YangXi2016/ROBOT/电路部分/巡线模块电路/巡线模块电路.jpg

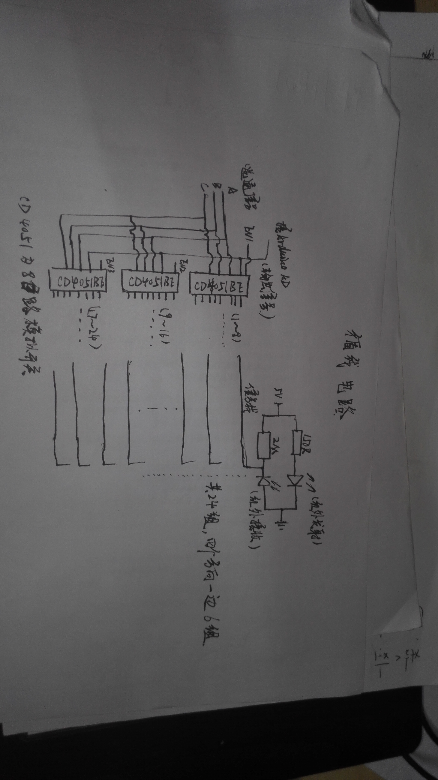
电路部分/巡线模块电路/巡线模块电路.jpg
