YangXi2016/ROBOT/机械部分/整机图/整机.jpg

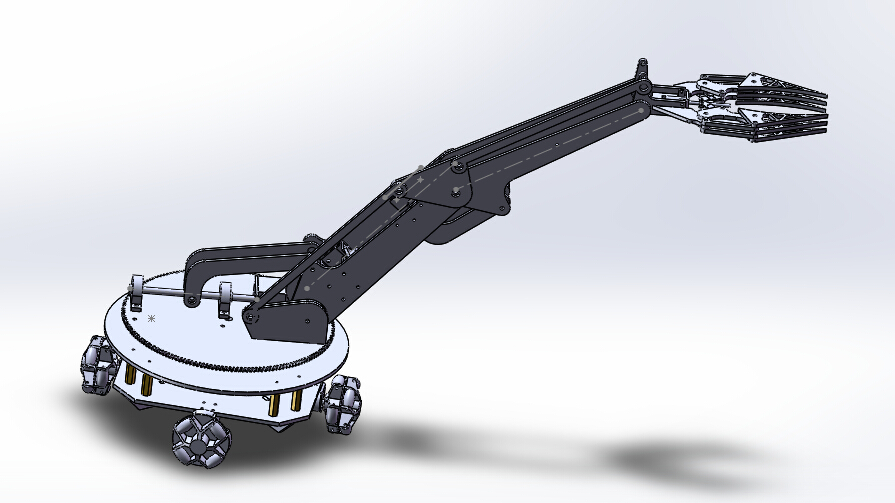
机械部分/整机图/整机.jpg
