YangXi2016/ROBOT/软件部分/上位机程序/ReadME.txt

			暂定组的上位机代码
	文件夹中包含中控杯暂定组的上位机代码，其中文件根目录为运行时的代码，detector
目录下为识别代码。
	由于版权原因，在这里不提供软件源代码，只提供相关的头文件、连接文件和可执行程
序。
