YangXi2016/ROBOT/机械部分/底座/底座.jpg

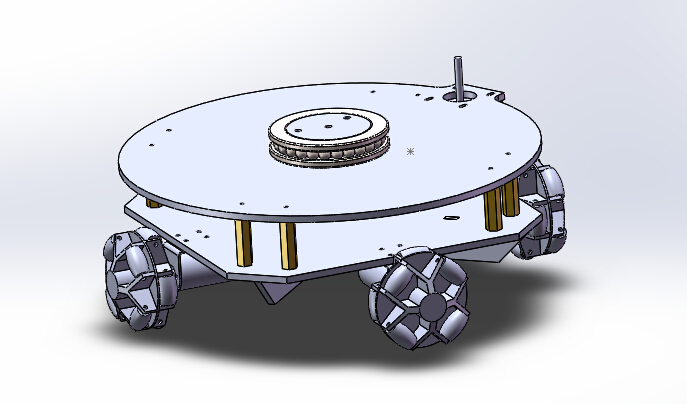
机械部分/底座/底座.jpg
