YangXi2016/ROBOT/机械部分/底座/底座加强肋.jpg

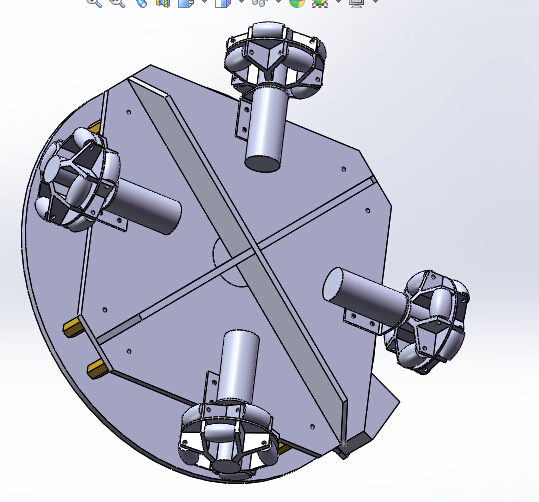
机械部分/底座/底座加强肋.jpg
