YangXi2016/ROBOT/机械部分/机械爪/机械爪.jpg

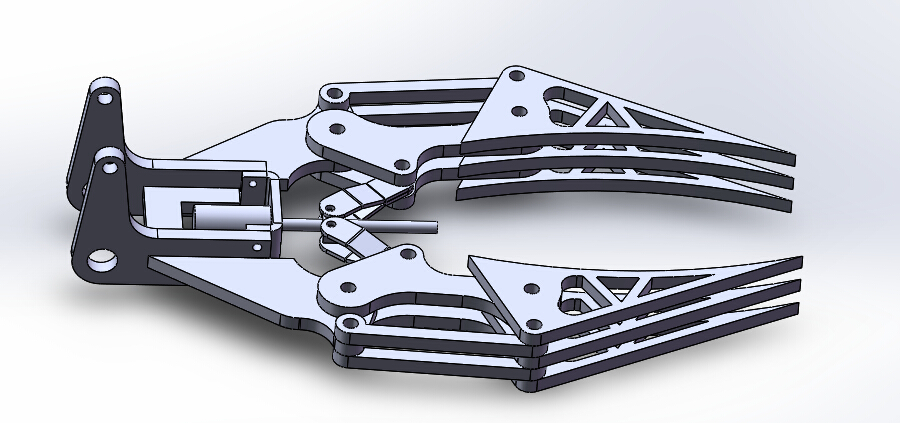
机械部分/机械爪/机械爪.jpg
