YangXi2016/ROBOT/机械部分/机械爪/机械爪详解.png

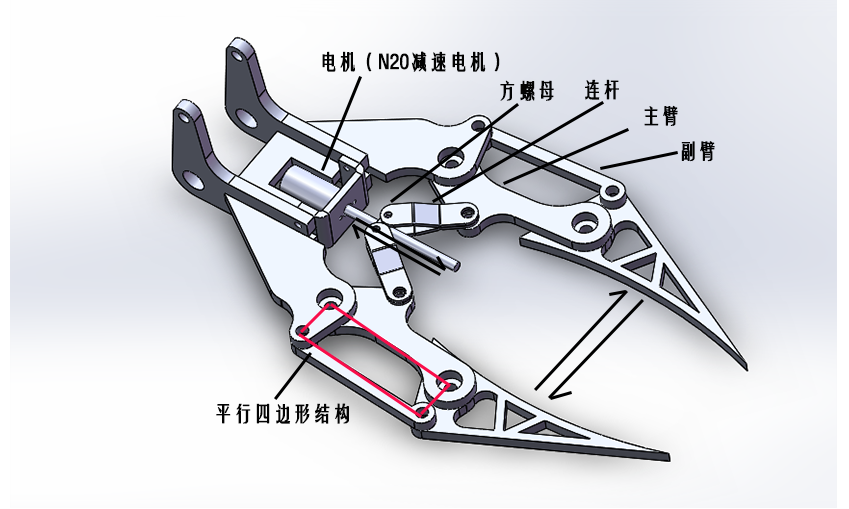
机械部分/机械爪/机械爪详解.png
