YangXi2016/ROBOT/机械部分/机械臂/机械臂.jpg

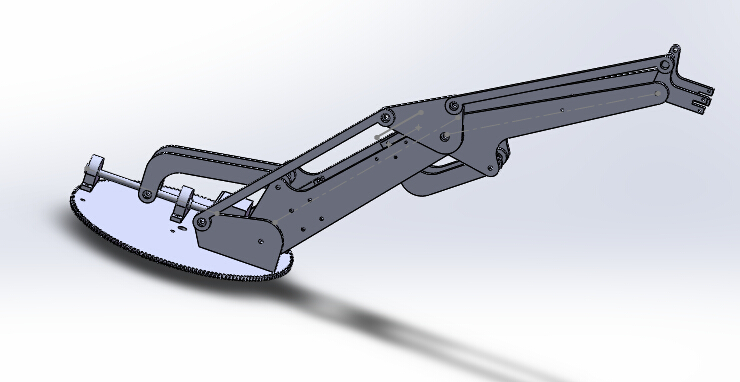
机械部分/机械臂/机械臂.jpg
