YangXi2016/ROBOT/机械部分/机械臂/机械臂详解1.png

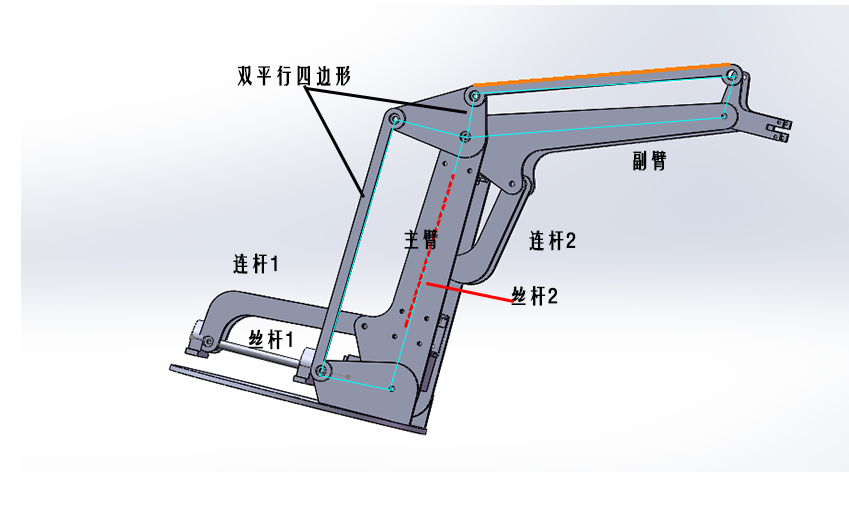
机械部分/机械臂/机械臂详解1.png
