YangXi2016/ROBOT/电路部分/机械臂部分电路/机械臂部分电路.jpg

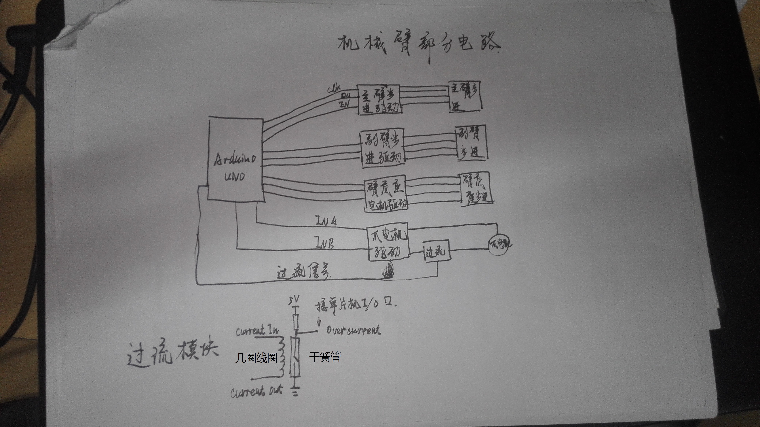
电路部分/机械臂部分电路/机械臂部分电路.jpg
