YangXi2016/ROBOT/软件部分/机械臂驱动模块/ArmControl.cpp

#include<stdio.h>
#include<stdlib.h>
#include<math.h>
#include "ArmControl.h"
#include "DEBUG.h"
//#include "stdafx.h"






int ArmPC::Arm_Move(float Target_X, float Target_Y, float Target_C)
{ 
	//Serial.println(millis());

	float A, B, C, D;
	float AngleTemp;
	float TargetX;     //鍑芥暟鍐呬娇鐢ㄧ殑鐗╀綋鐩爣鍧愭爣 
	float TargetY;
	float TargetC;
	float TargetLength;
	int OverFlag;
	
	if (InitFlag == 0)
	{
		return -1;
	}
	TargetX = Target_X;
	TargetY = Target_Y;
	TargetC = Target_C;
	while (1)
	{
		if (TargetC < ArmP.AngleBaseMin)
			TargetC += PI * 2;
		else if (TargetC > ArmP.AngleBaseMax)
			TargetC -= PI * 2;
		else
			break;
		Serial.println(TargetC);
	}
	

	OverFlag = Base_Assist(&TargetX, &TargetY, &TargetC);
	

	//閫氳繃瑙ｆ柟绋婰engthArm*(cos(a1)+cos(a2))=TargetX; 
	//          LengthArm*(sin(a1)+sin(a2))=TargetY;
	//          a1:AngleArmMain
	//          a2:AngleArmDeputy
	  A = TargetX * TargetX + TargetY * TargetY - 2 * ArmP.LengthArm * ArmP.LengthArm;
	  B = 2 * ArmP.LengthArm * ArmP.LengthArm;
	  if (fabs(A / B) > 1)
		  ArmS.ArmAngleMD = 0;
	  else
	      ArmS.ArmAngleMD = acos(A/ B);     //寰楀埌涓昏噦鍓噦涔嬮棿澶硅

	  A = TargetX * (cos(ArmS.ArmAngleMD) + 1);
	  B = TargetY * sin(ArmS.ArmAngleMD);
	  C = ArmP.LengthArm * (2 + 2 * cos(ArmS.ArmAngleMD));
	ArmS.ArmAngleMain = acos((A-B)/C) ;//寰楀埌涓昏噦涓庢按骞抽潰澶硅

	ArmS.ArmAngleDeputy = ArmS.ArmAngleMain - ArmS.ArmAngleMD;  //寰楀埌鍓噦涓庢按骞抽潰澶硅                                                                    

	  AngleTemp = PI - ArmS.ArmAngleMain - ArmP.AngleMainHand;
	  A = ArmP.LengthMainHand * cos(AngleTemp);
	  B = ArmP.LengthMainConnect * ArmP.LengthMainConnect - ArmP.LengthMainHand * ArmP.LengthMainHand * sin(AngleTemp) * sin(AngleTemp);
	  TargetLength = A + sqrt(B);
	ArmM.LengthMoveMain = TargetLength - LengthMain;
	LengthMain = TargetLength;

	  AngleTemp = PI - ArmS.ArmAngleMD - ArmP.AngleDeputyHand;
	  A = ArmP.LengthDeputyHand * cos(AngleTemp);
	  B = ArmP.LengthDeputyConnect * ArmP.LengthDeputyConnect - ArmP.LengthDeputyHand * ArmP.LengthDeputyHand * sin(AngleTemp) * sin(AngleTemp);
	  TargetLength = A + sqrt(B);
	ArmM.LengthMoveDeputy = TargetLength - LengthDeputy;
	LengthDeputy = TargetLength;
	
	ArmM.TurnC = TargetC - ArmS.ArmC;
	ArmS.ArmTipX = TargetX;
	ArmS.ArmTipY = TargetY;
	ArmS.ArmC    = TargetC;

	//Serial.println(millis());
	//Serial.println("CacultionOver");
	//Serial.println(ArmM.LengthMoveMain);
	//Serial.println(ArmM.LengthMoveDeputy);
	//Serial.println(ArmM.TurnC);
	OverFlag+=ArmU.Arm_Motion(ArmM.LengthMoveMain, ArmM.LengthMoveDeputy, ArmM.TurnC);
	return OverFlag;


}

void ArmPC::Move_Forward(float Target_X, float Target_Y, float Target_C)
{
	int flag;
	float TargetX;     //鍑芥暟鍐呬娇鐢ㄧ殑鐗╀綋鐩爣鍧愭爣 
	float TargetY;
	float TargetC;
	float Distance;//鐖皷閲岀洰鏍囩殑璺濈
	TargetX = Target_X;
	TargetY = Target_Y;
	TargetC = Target_C;


  //Serial.println("fuck");
	DEB("TargetX ");
	DEB(TargetX);
	DEB("TargetY ");
	DEB(TargetY);
	DEB("TargetC ");
	DEB(TargetC);
	DEB("TipX");
	DEB(ArmS.ArmTipX);
	DEB("TipY");
	DEB(ArmS.ArmTipY);
	DEB("ArmM.LengthMoveMain");
	DEB(ArmM.LengthMoveMain);
	DEB("ArmM.LengthMoveDeputy");
	DEB(ArmM.LengthMoveDeputy);
   do
	{
		Distance = TargetX - ArmS.ArmTipX;
		DEB("Distance ");
		DEB(Distance);
		DEB("TipX");
		DEB(ArmS.ArmTipX);
		DEB("TipY");
		DEB(ArmS.ArmTipY);
		DEB("ArmM.LengthMoveMain");
		DEB(ArmM.LengthMoveMain);
		DEB("ArmM.LengthMoveDeputy");
		DEB(ArmM.LengthMoveDeputy);
		DEB("\n");
		if (Distance >= 10)
		{   

			flag = Arm_Move(ArmS.ArmTipX + 10, TargetY, TargetC);
		}
		else if(Distance <= -5)
			flag = Arm_Move(ArmS.ArmTipX - 10, TargetY, TargetC);

		else
		{
			flag = Arm_Move(TargetX, TargetY, TargetC);
			break;
		}
   } while (ArmM.LengthMoveMain != 0 || ArmM.LengthMoveDeputy != 0 || ArmM.TurnC != 0);
	}



void ArmPC::Init_Arm(int firsttime)
{


    LengthMain = 201.4;
	LengthDeputy = 151;
	ArmM.LengthMoveDeputy = 130;
	ArmM.LengthMoveMain = 85;
	ArmM.TurnC = -2 * PI;
	ArmS.ArmC = ArmP.AngleBaseMin;//鍧愭爣绯荤殑鍘熷洜
	ArmS.ArmTipX = 206.88;
	ArmS.ArmTipY = 267.15;
	BPM.BasePlateMoveA = 0;
	BPM.BasePlateMoveB = 0;
	
	if (firsttime == 1)
	{ 
		ArmU.DafaultSpeedMain = DAFAULT_ARM_SPEED / 2;
		ArmM.LengthMoveDeputy = 30;
		ArmM.LengthMoveMain = 30;
		ArmM.TurnC = 0;
		ArmU.Init(ArmM.LengthMoveMain, ArmM.LengthMoveDeputy, ArmM.TurnC);
		
		ArmU.DafaultSpeedMain = DAFAULT_ARM_SPEED ;
		ArmM.LengthMoveDeputy = 100;
		ArmM.LengthMoveMain = 55;
		ArmM.TurnC = -2*PI;
		ArmU.Init(ArmM.LengthMoveMain, ArmM.LengthMoveDeputy, ArmM.TurnC);
	}
	else
	{
		ArmU.DafaultSpeedMain = DAFAULT_ARM_SPEED;
		ArmU.Init(ArmM.LengthMoveMain, ArmM.LengthMoveDeputy, ArmM.TurnC);
	}
	ArmU.DafaultSpeedMain = DAFAULT_ARM_SPEED;
	InitFlag = 1;

}

void ArmPC::Arm_Wait()
{
	//Serial.println("backing");
	int i;
	//Serial.println("movingtoinit");
	i = Arm_Move(206.88, 267.15,ArmS.ArmC);//鍥炲幓

	i= ArmU.Arm_Motion(15, 15, 0);

	ArmS.ArmTipX = 206.88;
	ArmS.ArmTipY = 267.15;
	LengthMain = 201.4;
	LengthDeputy = 151;

}

ArmPC::ArmPC()
{

	ArmP.LengthMainHand = 66;
	ArmP.AngleMainHand = 0.7155850;
	ArmP.LengthMainConnect = 156;
	ArmP.LengthDeputyHand = 62.5;
	ArmP.AngleDeputyHand = 0.8726646;
	ArmP.LengthDeputyConnect = 106.07;
	ArmP.LengthArm = 250;              //涓昏噦鍜屽壇鑷傜殑闀垮害
	ArmP.AngleMainMin = 0.5149;
	ArmP.AngleMainMax = 100.5/180*PI;          //鍚岀悊 
	ArmP.AngleMDMin = 0;
	ArmP.AngleMDMax = 94.5/180*PI;            //鍚岀悊 
	ArmP.AngleBaseMax = PI*1.45;
	ArmP.AngleBaseMin = -PI / 2;

	InitFlag = 0;
}

int ArmPC::Base_Assist(float *Target_X, float *Target_Y, float *Target_C)
{
	float TargetX, TargetY, TargetC;
	
	TargetX = *Target_X;
	TargetY = *Target_Y;
	TargetC = *Target_C;
	
	int OverLimitFlag=0;
	int i;//寰幆鍙橀噺 
	float BaseMovetoC = 0;
	float MotionTemp;    //璁＄畻涓殑涓棿鍙橀噺 
	struct Boundary
					 //鑷鐢诲嚭鍓噦灏栧彲浠ュ埌杈剧殑鑼冨洿
	{
		float CenterX; //杈圭晫鍦嗗績
		float CenterY;
		float Radius;  //杈圭晫鍗婂緞骞虫柟
		float Ymax;    //杈圭晫Y鑼冨洿
		float Ymin;
		float Distance;
	}B[4];

	B[0].CenterX = ArmP.LengthArm*cos(ArmP.AngleMainMax);
	B[0].CenterY = ArmP.LengthArm*sin(ArmP.AngleMainMax);
	B[0].Radius = ArmP.LengthArm*ArmP.LengthArm;
	if (ArmP.AngleMainMax - ArmP.AngleMDMin >= PI / 2)
		B[0].Ymax = B[0].CenterY + ArmP.LengthArm;
	else
		B[0].Ymax = B[0].CenterY + ArmP.LengthArm*sin(ArmP.AngleMainMax - ArmP.AngleMDMin);
	B[0].Ymin = B[0].CenterY + ArmP.LengthArm*sin(ArmP.AngleMainMax - ArmP.AngleMDMax);

	B[1].CenterX = 0;
	B[1].CenterY = 0;
	B[1].Radius = 2 * ArmP.LengthArm*ArmP.LengthArm*(1 - cos(PI - ArmP.AngleMDMax));
	B[1].Ymax = B[0].Ymin;
	B[1].Ymin = ArmP.LengthArm*(sin(ArmP.AngleMainMin) + sin(ArmP.AngleMainMin - ArmP.AngleMDMax));

	B[2].CenterX = ArmP.LengthArm*cos(ArmP.AngleMainMin);
	B[2].CenterY = ArmP.LengthArm*sin(ArmP.AngleMainMin);
	B[2].Radius = ArmP.LengthArm*ArmP.LengthArm;
	B[2].Ymax = B[2].CenterY + ArmP.LengthArm*sin(ArmP.AngleMainMin - ArmP.AngleMDMin);
	B[2].Ymin = B[1].Ymin;

	B[3].CenterX = 0;
	B[3].CenterY = 0;
	if (ArmP.AngleMDMin <= 0)
	{
		B[3].Radius = 4 * ArmP.LengthArm*ArmP.LengthArm;
		if (ArmP.AngleMainMax <= PI / 2)
			B[3].Ymax = 2 * ArmP.LengthArm*sin(ArmP.AngleMainMax);
		else
			B[3].Ymax = 2 * ArmP.LengthArm;
	}
	else
	{
		B[3].Radius = 2 * ArmP.LengthArm*ArmP.LengthArm*(1 - cos(PI - ArmP.AngleMDMin));
		if (ArmP.AngleMainMax - ArmP.AngleMDMin / 2 <= PI / 2)
			B[3].Ymax = sqrt(B[3].Radius)*sin(ArmP.AngleMainMax - ArmP.AngleMDMin / 2);
		else
			B[3].Ymax = sqrt(B[3].Radius);
	}
	B[3].Ymin = B[1].Ymin;

	//y鏂瑰悜瓒婄晫鍒ゆ柇 
	if (TargetY>B[3].Ymax)
	{
		TargetY = B[3].Ymax;
		OverLimitFlag = OverLimitFlag + 2;
	}
	else if (TargetY<B[1].Ymin)
	{
		TargetY = B[1].Ymin;
		OverLimitFlag = OverLimitFlag + 2;

	}



	if (TargetX > 2 * ArmP.LengthArm + 1)
	{
		BaseMovetoC = TargetX - 2 * ArmP.LengthArm -1 + BaseMovetoC;
		TargetX = 2 * ArmP.LengthArm + 1;

	}
	else if (TargetX < -ArmP.LengthArm)     //鍚岀悊 
	{
		BaseMovetoC = TargetX + ArmP.LengthArm + 1 + BaseMovetoC;
		TargetX = -ArmP.LengthArm;
	}


	for (i = 0; i<4; i++)
	{
		B[i].Distance = (TargetX - B[i].CenterX)*(TargetX - B[i].CenterX) + (TargetY - B[i].CenterY)*(TargetY - B[i].CenterY);
		if (B[i].Distance<B[i].Radius && TargetY <= B[i].Ymax && TargetY >= B[i].Ymin && (i == 0 || i == 1))
		{
			MotionTemp = sqrt(B[i].Radius - (TargetY - B[i].CenterY)*(TargetY - B[i].CenterY)) + B[i].CenterX;
			BaseMovetoC = TargetX - MotionTemp + BaseMovetoC;
			TargetX = MotionTemp;
			OverLimitFlag = OverLimitFlag + 1;
			break;
		}
		else if (B[i].Distance>B[i].Radius && TargetY <= B[i].Ymax && TargetY >= B[i].Ymin && (i == 2 || i == 3))
		{
			MotionTemp = sqrt(B[i].Radius - (TargetY - B[i].CenterY)*(TargetY - B[i].CenterY)) + B[i].CenterX;
			BaseMovetoC = TargetX - MotionTemp + BaseMovetoC;
			TargetX = MotionTemp;
			OverLimitFlag = OverLimitFlag + 1;
			break;
		}
	}

	BPM.BasePlateMoveA = BaseMovetoC*cos(TargetC);
	BPM.BasePlateMoveB = BaseMovetoC*sin(TargetC);

	*Target_X=TargetX;
	*Target_Y=TargetY;
	*Target_C=TargetC;
	return OverLimitFlag;

}
