YangXi2016/ROBOT/(notices)

Notices in the files:
软件部分/上位机程序/SerialPort.h:
Copyright (c) 2009, »ªÖÐ¿Æ¼¼´óÑ§tickTick Group £¨°æÈ¨ÉùÃ÷£©
All rights reserved.
